FLSylar/Mechanical-Design-Project-2026/README.md

Group:
Joseph Ostrand
Daniel Romero
Sarah Roza
AJ Pacheco
Laysha Esquer 
Danalynn Phan Geronimo
Miles Abril
Jacobo Castillo
Sophia Sanchez

Files are labeled first by phase. The reports also have the corresponding video link in it.
