FLSylar/Mechanical-Design-Project-2026/whirpool turbine cad files/Assem1.SLDASM

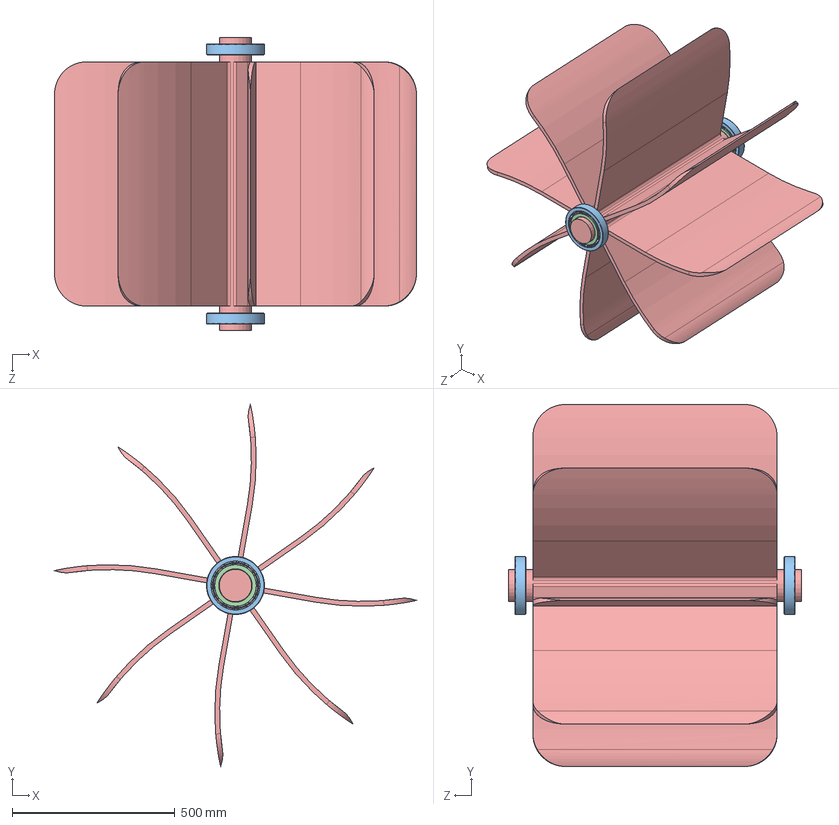
[picture p23: CAD file, 2026-03-26]
whirpool turbine cad files/Assem1.SLDASM
1111.2 x 1111.2 x 900.0 mm
runner
in ring x 2
out ring x 2
spacer x 4
ball x 24
