FLSylar/Mechanical-Design-Project-2026/whirpool turbine cad files/bearing.SLDASM

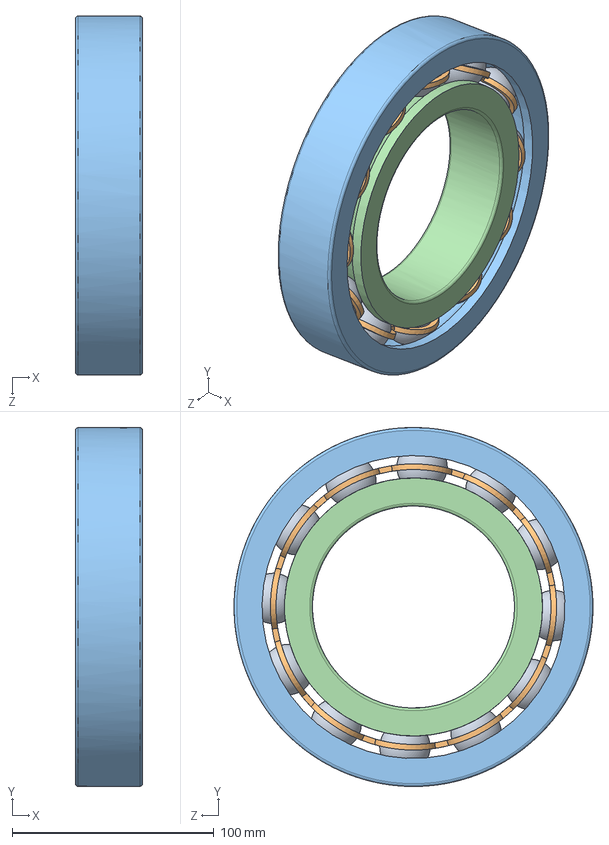
[picture p24: CAD file, 2026-03-26]
whirpool turbine cad files/bearing.SLDASM
33.3 x 177.8 x 177.7 mm
in ring
out ring
spacer x 2
ball x 12
