FLSylar/Mechanical-Design-Project-2026/Phase 3 Solidworks glb and Components/turbine 3d print.SLDASM

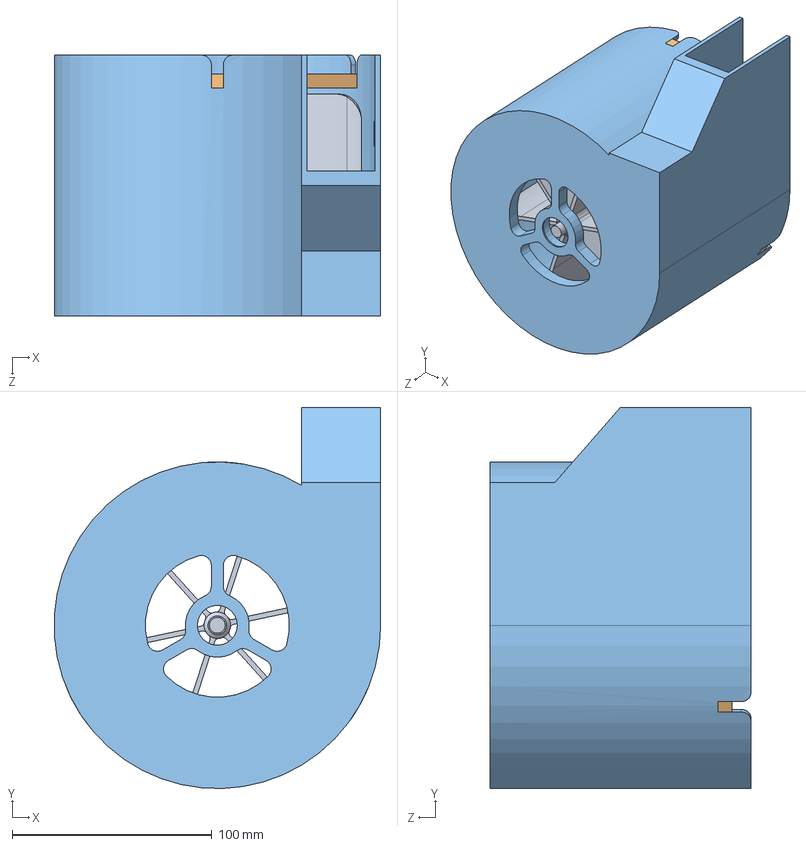
[picture p25: CAD file, 2026-05-01]
Phase 3 Solidworks glb and Components/turbine 3d print.SLDASM
163.3 x 190.6 x 130.6 mm
turbine structure 3d print
turbine support 3d print
runner 3d print
