FLSylar/Mechanical-Design-Project-2026/whirpool turbine cad files/whirpool turbine.SLDASM

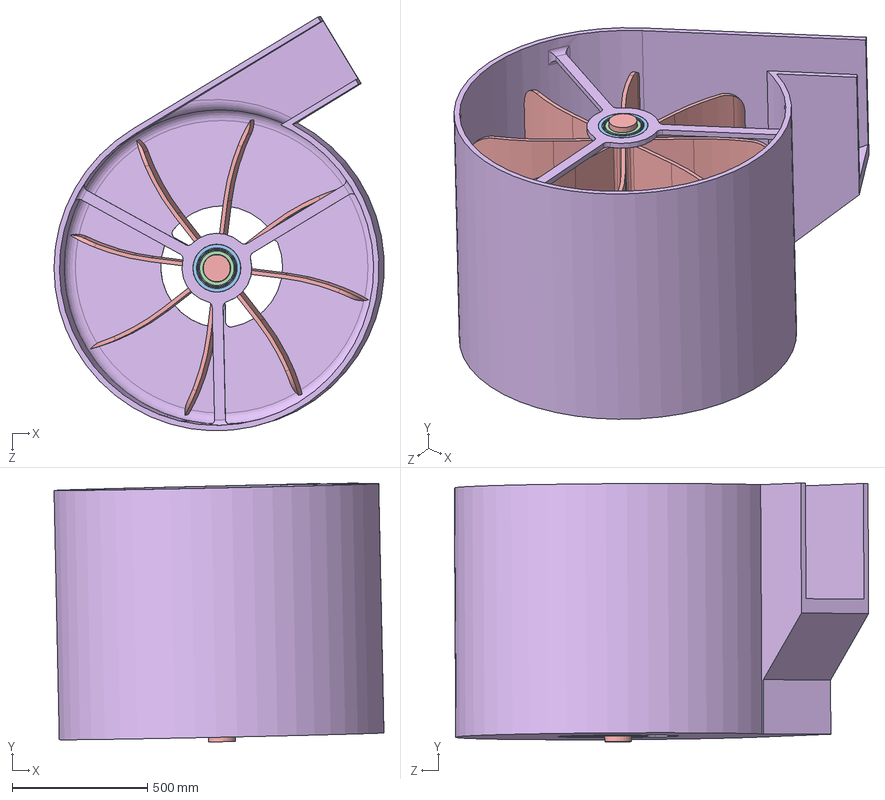
[picture p26: CAD file, 2026-03-26]
whirpool turbine cad files/whirpool turbine.SLDASM
1218.0 x 955.8 x 1529.8 mm
turbine structure
runner
in ring x 2
out ring x 2
spacer x 4
ball x 24
