FLSylar/Mechanical-Design-Project-2026/Phase 3 Solidworks glb and Components/turbine support 3d print.SLDPRT

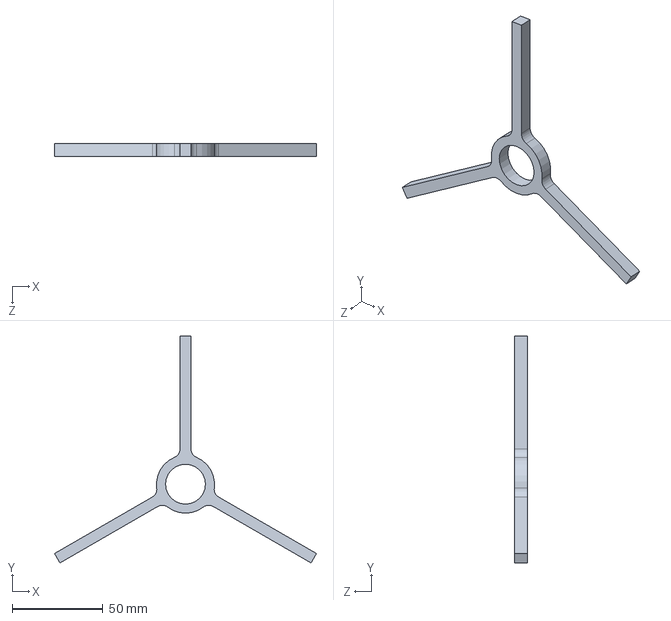
[picture p27: CAD file, 2026-05-01]
Phase 3 Solidworks glb and Components/turbine support 3d print.SLDPRT
144.5 x 125.1 x 7.00 mm
