FLSylar/Mechanical-Design-Project-2026/whirpool turbine cad files/runner.SLDPRT

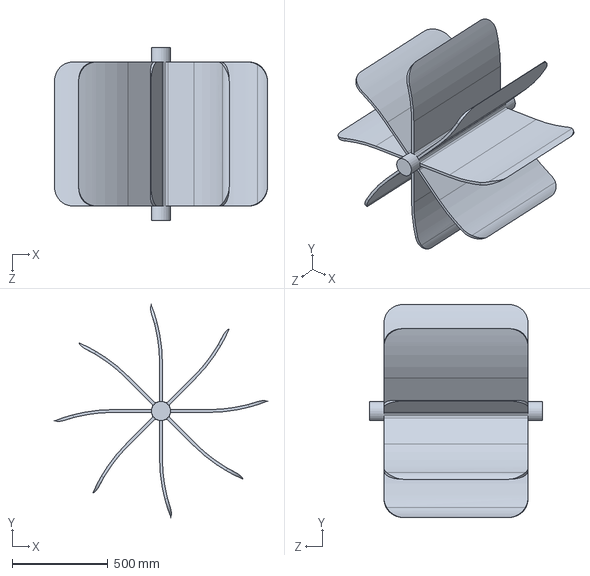
[picture p28: CAD file, 2026-03-26]
whirpool turbine cad files/runner.SLDPRT
1110.1 x 1110.1 x 900.0 mm
