FLSylar/Mechanical-Design-Project-2026/Phase 3 Solidworks glb and Components/runner 3d print.SLDPRT

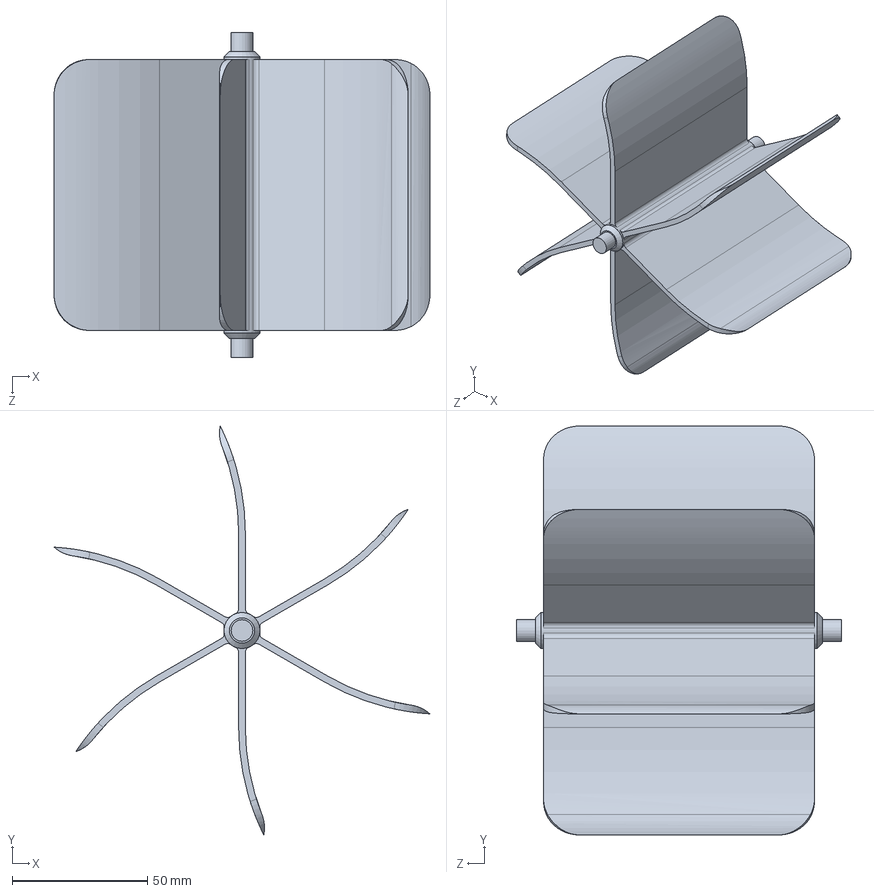
[picture p29: CAD file, 2026-05-01]
Phase 3 Solidworks glb and Components/runner 3d print.SLDPRT
138.8 x 151.0 x 120.0 mm
