FLSylar/Mechanical-Design-Project-2026/Phase 3 Solidworks glb and Components/turbine structure 3d print.SLDPRT

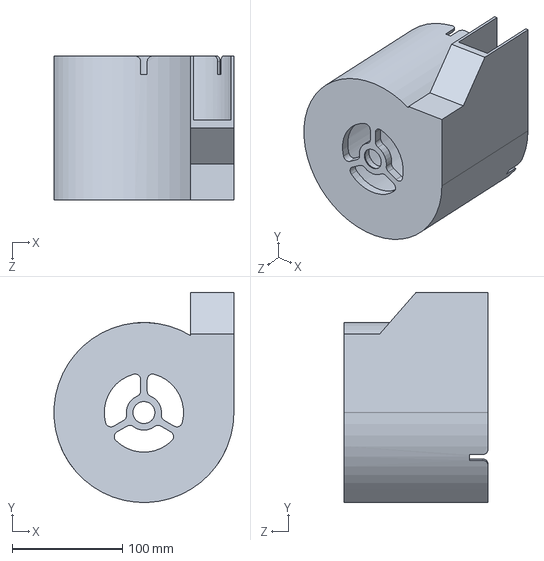
[picture p30: CAD file, 2026-05-01]
Phase 3 Solidworks glb and Components/turbine structure 3d print.SLDPRT
163.3 x 190.6 x 130.6 mm
