FLSylar/Mechanical-Design-Project-2026/whirpool turbine cad files/spacer.SLDPRT

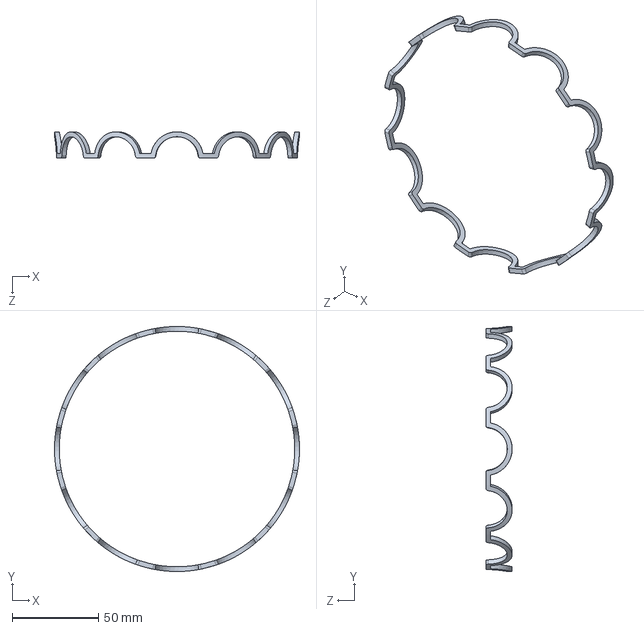
[picture p31: CAD file, 2026-03-26]
whirpool turbine cad files/spacer.SLDPRT
141.7 x 141.7 x 15.3 mm
