FLSylar/Mechanical-Design-Project-2026/whirpool turbine cad files/turbine blade.SLDPRT

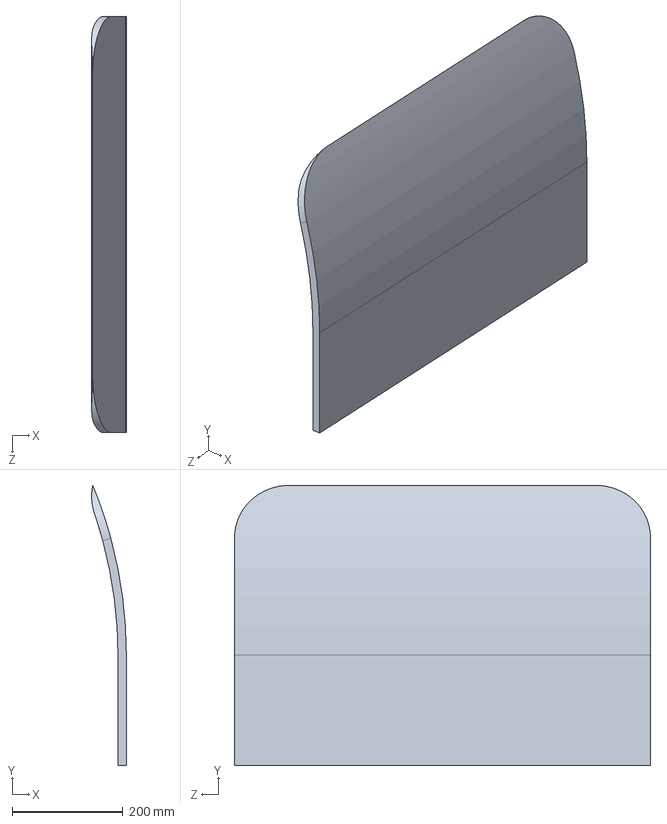
[picture p32: CAD file, 2026-03-26]
whirpool turbine cad files/turbine blade.SLDPRT
62.6 x 505.6 x 750.0 mm
