FLSylar/Mechanical-Design-Project-2026/whirpool turbine cad files/out ring.SLDPRT

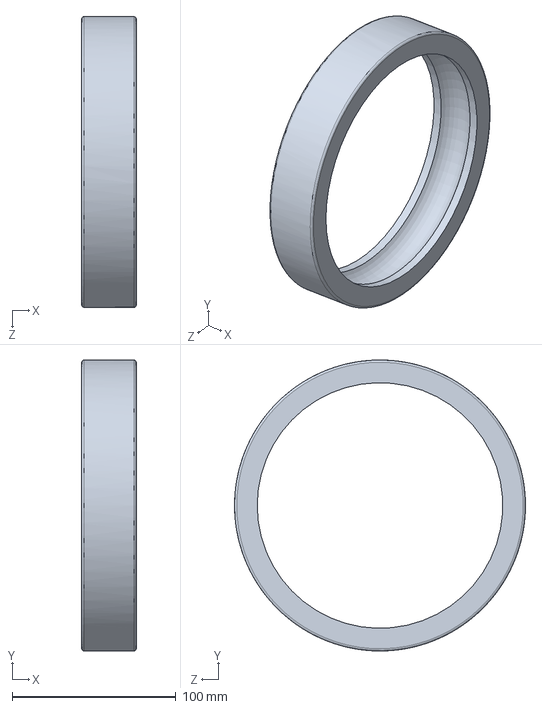
[picture p33: CAD file, 2026-03-26]
whirpool turbine cad files/out ring.SLDPRT
33.3 x 177.7 x 177.8 mm
