FLSylar/Mechanical-Design-Project-2026/whirpool turbine cad files/turbine structure.SLDPRT

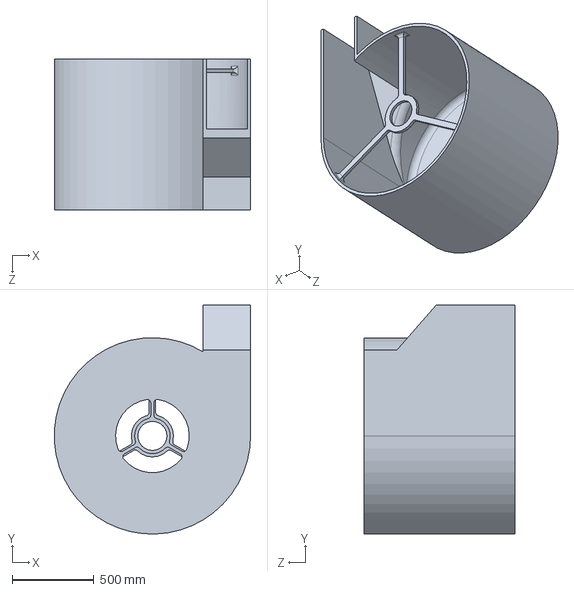
[picture p34: CAD file, 2026-03-26]
whirpool turbine cad files/turbine structure.SLDPRT
1198.8 x 1399.7 x 920.0 mm
