FLSylar/Mechanical-Design-Project-2026/whirpool turbine cad files/in ring.SLDPRT

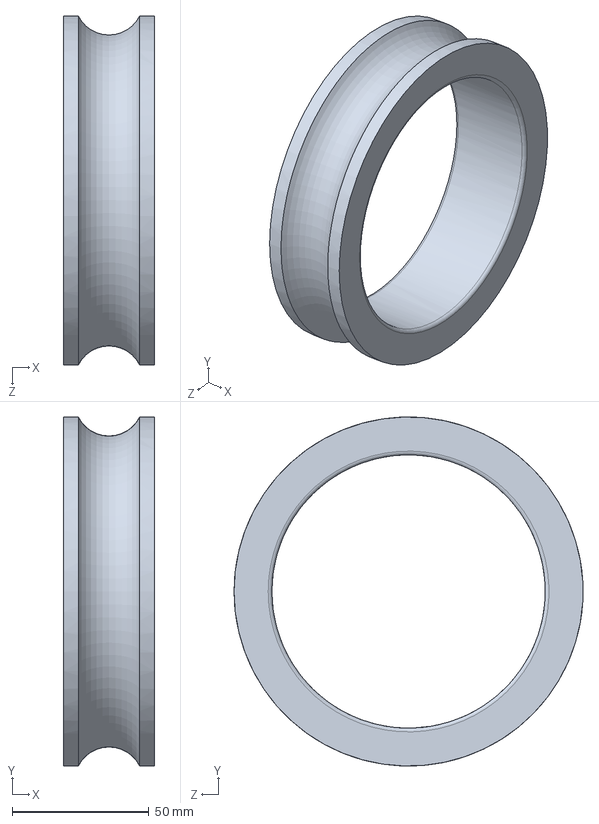
[picture p35: CAD file, 2026-03-26]
whirpool turbine cad files/in ring.SLDPRT
33.3 x 127.7 x 127.7 mm
