FLSylar/Mechanical-Design-Project-2026/whirpool turbine cad files/ball.SLDPRT

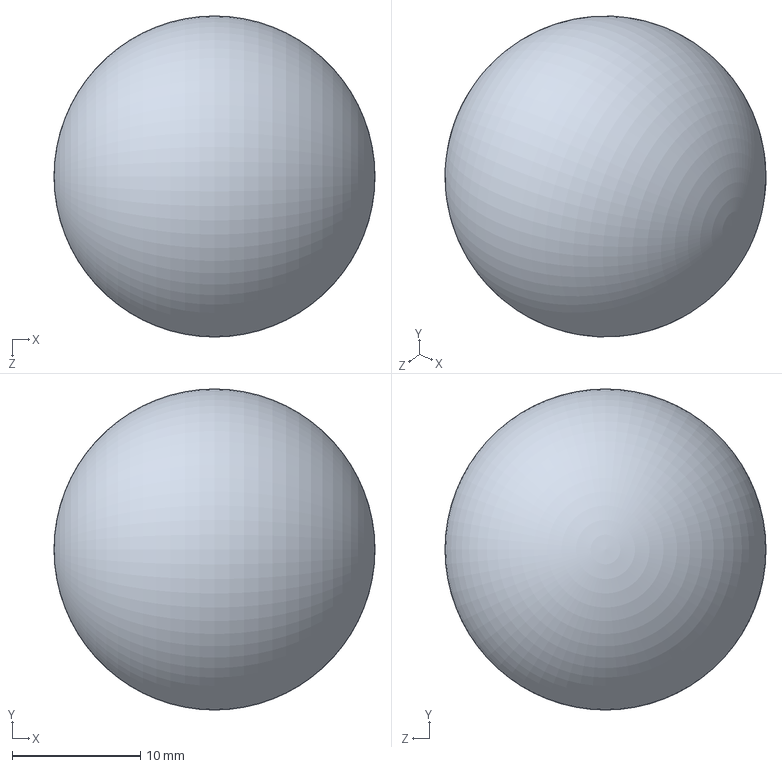
[picture p36: CAD file, 2026-03-26]
whirpool turbine cad files/ball.SLDPRT
25.0 x 25.0 x 25.0 mm
